kotek-7/DRC-CCTL2026/3dshapes/SO8_SOT96-1_NXP.step

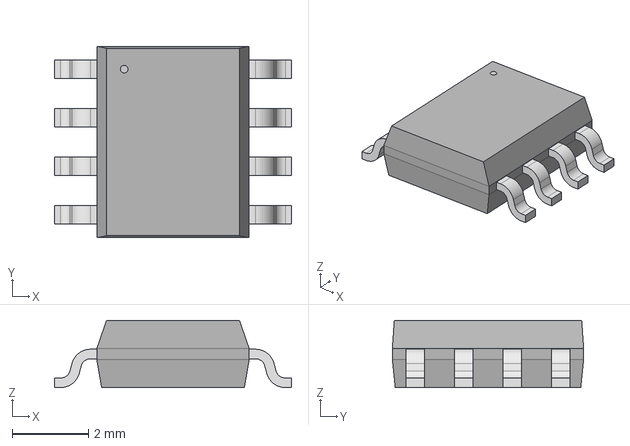
[picture p1: CAD file, 2026-04-17]
3dshapes/SO8_SOT96-1_NXP.step
6.20 x 5.00 x 1.75 mm
