kotek-7/DRC-CCTL2026/3dshapes/AQM1602Y-NLW-FBW.step

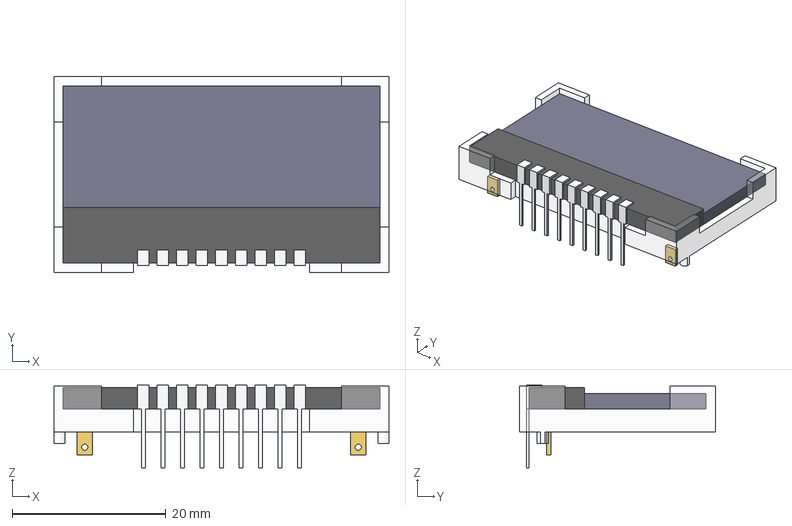
[picture p2: CAD file, 2026-03-31]
3dshapes/AQM1602Y-NLW-FBW.step
43.6 x 25.5 x 10.8 mm
