kotek-7/DRC-CCTL2026/3dshapes/SN74AHCT1G125DBVR.step

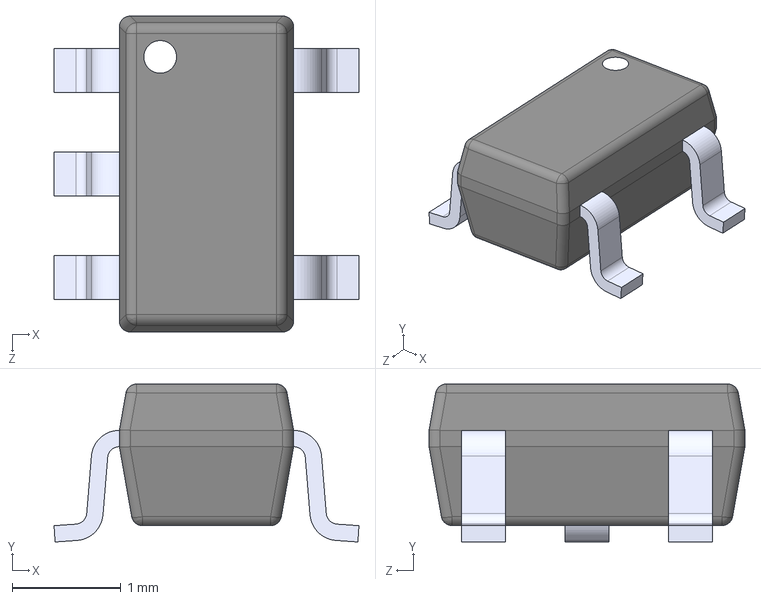
[picture p3: CAD file, 2026-03-31]
3dshapes/SN74AHCT1G125DBVR.step
2.80 x 1.45 x 2.90 mm
