kotek-7/DRC-CCTL2026/3dshapes/AZ1117CH-3.3TRG1.STEP

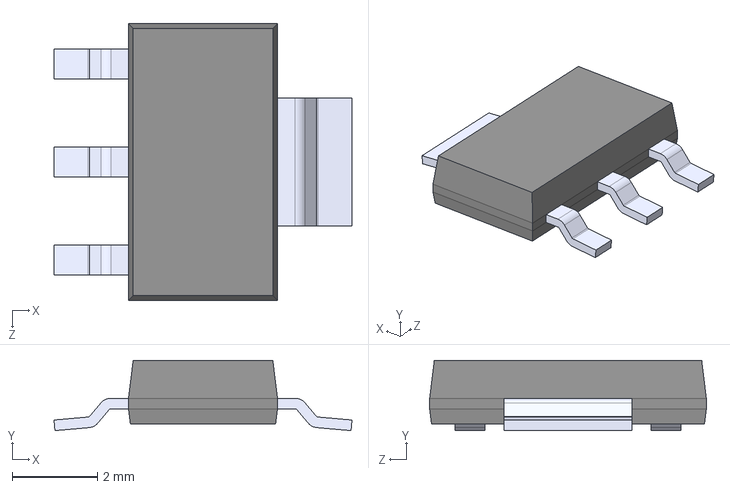
[picture p4: CAD file, 2026-03-31]
3dshapes/AZ1117CH-3.3TRG1.STEP
7.00 x 1.65 x 6.50 mm
