kotek-7/DRC-CCTL2026/DRC-CCTL2026.kicad_pcb

## KiCad design DRC-CCTL2026.kicad_pcb (2026-04-17)

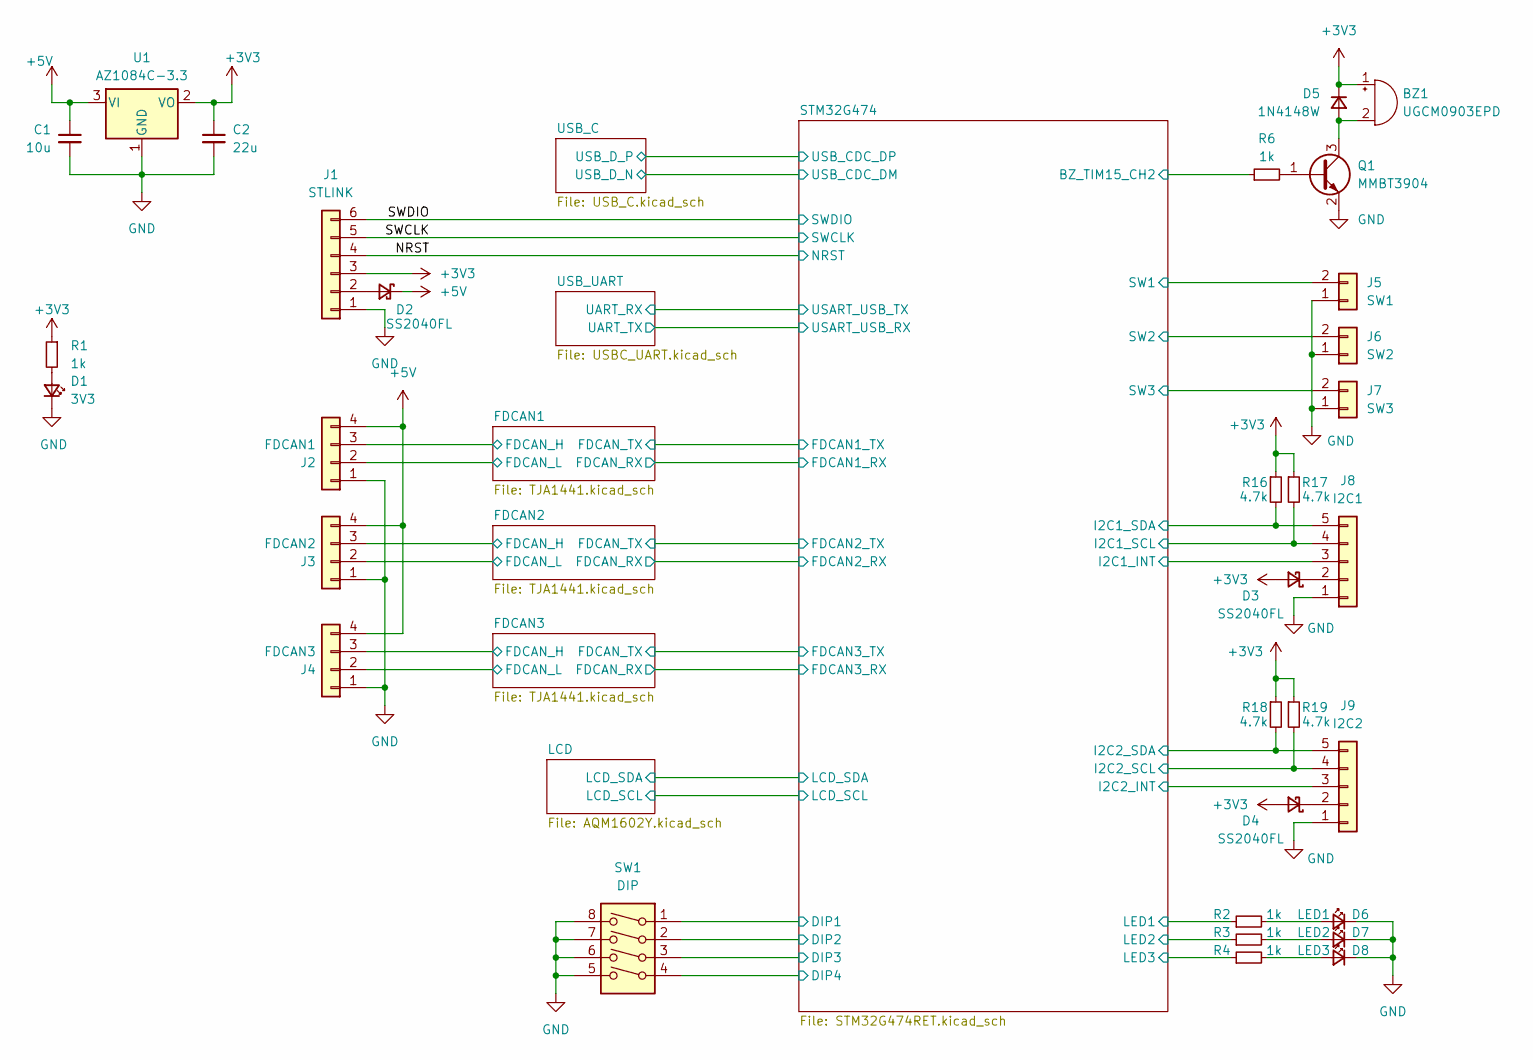
[picture p5: schematic DRC-CCTL2026.kicad_sch]

Parts:
BZ1: UGCM0903EPD; UGCM0903EPD_5_0
C1: 10u; C_0805_2012Metric_Pad1.18x1.45mm_HandSolder
C2: 22u; C_0805_2012Metric_Pad1.18x1.45mm_HandSolder
D1: 3V3; LED_0603_1608Metric_Pad1.05x0.95mm_HandSolder
D2, D3, D4: SS2040FL; D_SOD-123F
D5: 1N4148W; D_SOD-123
D6: LED1; LED_0603_1608Metric_Pad1.05x0.95mm_HandSolder
D7: LED2; LED_0603_1608Metric_Pad1.05x0.95mm_HandSolder
D8: LED3; LED_0603_1608Metric_Pad1.05x0.95mm_HandSolder
J1: STLINK; IDC-Header_2x03_P2.54mm_Vertical
J2: FDCAN1; JST_XH_S4B-XH-A_1x04_P2.50mm_Horizontal; LCSC x
J3: FDCAN2; JST_XH_S4B-XH-A_1x04_P2.50mm_Horizontal; LCSC x
J4: FDCAN3; JST_XH_S4B-XH-A_1x04_P2.50mm_Horizontal; LCSC x
J5: SW1; JST_XH_B2B-XH-A_1x02_P2.50mm_Vertical
J6: SW2; JST_XH_B2B-XH-A_1x02_P2.50mm_Vertical
J7: SW3; JST_XH_B2B-XH-A_1x02_P2.50mm_Vertical
J8: I2C1; JST_XH_S5B-XH-A_1x05_P2.50mm_Horizontal
J9: I2C2; JST_XH_S5B-XH-A_1x05_P2.50mm_Horizontal
Q1: MMBT3904; SOT-23
R1, R2, R3, R4, R6: 1k; R_0603_1608Metric_Pad0.98x0.95mm_HandSolder
R16, R17, R18, R19: 4.7k; R_0603_1608Metric_Pad0.98x0.95mm_HandSolder
SW1: DIP; SW_DIP_SPSTx04_Slide_Copal_CHS-04B_W7.62mm_P1.27mm
U1: AZ1084C-3.3; TO-252-2

Connections:
+3V3: BZ1.1 (+), C2.1, D3.2 (A), D4.2 (A), D5.1 (K), J1.3, R1.1, R16.1, R17.1, R18.1, R19.1, U1.2 (VO); also elsewhere on the board
+5V: C1.1, D2.1 (K), J2.4, J3.4, J4.4, U1.3 (VI); also elsewhere on the board
/FDCAN1/FDCAN_H: J2.3; also elsewhere on the board
/FDCAN1/FDCAN_L: J2.2; also elsewhere on the board
/FDCAN2/FDCAN_H: J3.3; also elsewhere on the board
/FDCAN2/FDCAN_L: J3.2; also elsewhere on the board
/FDCAN3/FDCAN_H: J4.3; also elsewhere on the board
/FDCAN3/FDCAN_L: J4.2; also elsewhere on the board
/NRST: J1.4; also elsewhere on the board
/STM32G474/BZ_TIM15_CH2: R6.1; also elsewhere on the board
/STM32G474/DIP1: SW1.1; also elsewhere on the board
/STM32G474/DIP2: SW1.2; also elsewhere on the board
/STM32G474/DIP3: SW1.3; also elsewhere on the board
/STM32G474/DIP4: SW1.4; also elsewhere on the board
/STM32G474/I2C1_INT: J8.3; also elsewhere on the board
/STM32G474/I2C1_SCL: J8.4, R17.2; also elsewhere on the board
/STM32G474/I2C1_SDA: J8.5, R16.2; also elsewhere on the board
/STM32G474/I2C2_INT: J9.3; also elsewhere on the board
/STM32G474/I2C2_SCL: J9.4, R19.2; also elsewhere on the board
/STM32G474/I2C2_SDA: J9.5, R18.2; also elsewhere on the board
/STM32G474/LED1: R2.1; also elsewhere on the board
/STM32G474/LED2: R3.1; also elsewhere on the board
/STM32G474/LED3: R4.1; also elsewhere on the board
/STM32G474/SW1: J5.2; also elsewhere on the board
/STM32G474/SW2: J6.2; also elsewhere on the board
/STM32G474/SW3: J7.2; also elsewhere on the board
/SWCLK: J1.5; also elsewhere on the board
/SWDIO: J1.6; also elsewhere on the board
GND: C1.2, C2.2, D1.1 (K), D6.1 (K), D7.1 (K), D8.1 (K), J1.1, J2.1, J3.1, J4.1, J5.1, J6.1, J7.1, J8.1, J9.1, Q1.2 (E), SW1.5, SW1.6, SW1.7, SW1.8, U1.1 (GND); also elsewhere on the board
unnamed: BZ1.2 (-), D5.2 (A), Q1.3 (C)
unnamed: D1.2 (A), R1.2
unnamed: D2.2 (A), J1.2
unnamed: D3.1 (K), J8.2
unnamed: D4.1 (K), J9.2
unnamed: D6.2 (A), R2.2
unnamed: D7.2 (A), R3.2
unnamed: D8.2 (A), R4.2
unnamed: Q1.1 (B), R6.2

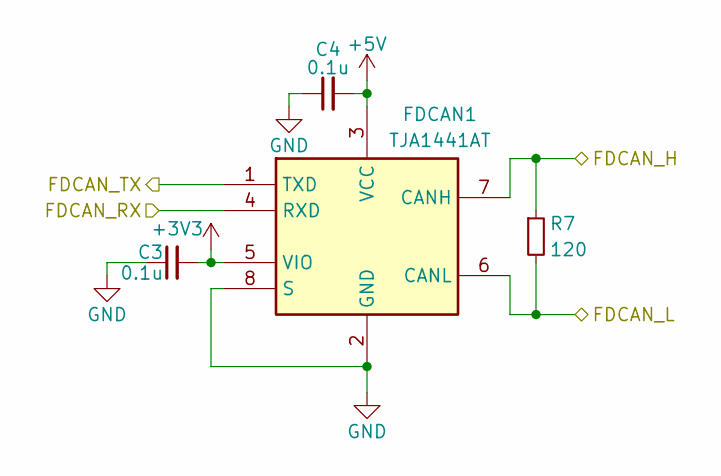
[picture p6: schematic TJA1441.kicad_sch]

Parts:
C3, C4: 0.1u; C_0603_1608Metric_Pad1.08x0.95mm_HandSolder
FDCAN1: TJA1441AT; SO8_SOT96-1_NXP; Manufacturer_Part_Number TJA1441AT
R7: 120; R_0603_1608Metric_Pad0.98x0.95mm_HandSolder

Connections:
+3V3: C3.2, FDCAN1.5 (VIO); also elsewhere on the board
+5V: C4.2, FDCAN1.3 (VCC); also elsewhere on the board
/FDCAN1/FDCAN_H: FDCAN1.7 (CANH), R7.1; also elsewhere on the board
/FDCAN1/FDCAN_L: FDCAN1.6 (CANL), R7.2; also elsewhere on the board
/FDCAN1/FDCAN_RX: FDCAN1.4 (RXD); also elsewhere on the board
/FDCAN1/FDCAN_TX: FDCAN1.1 (TXD); also elsewhere on the board
GND: C3.1, C4.1, FDCAN1.2 (GND), FDCAN1.8 (S); also elsewhere on the board

Parts of its further copies:
C5, C6, C7, C8: 0.1u; C_0603_1608Metric_Pad1.08x0.95mm_HandSolder
FDCAN2, FDCAN3: TJA1441AT; SO8_SOT96-1_NXP; Manufacturer_Part_Number TJA1441AT
R8, R9: 120; R_0603_1608Metric_Pad0.98x0.95mm_HandSolder

Connections of its further copies:
+3V3: C5.2, C7.2, FDCAN2.5 (VIO), FDCAN3.5 (VIO); also elsewhere on the board
+5V: C6.2, C8.2, FDCAN2.3 (VCC), FDCAN3.3 (VCC); also elsewhere on the board
/FDCAN2/FDCAN_H: FDCAN2.7 (CANH), R8.1; also elsewhere on the board
/FDCAN2/FDCAN_L: FDCAN2.6 (CANL), R8.2; also elsewhere on the board
/FDCAN2/FDCAN_RX: FDCAN2.4 (RXD); also elsewhere on the board
/FDCAN2/FDCAN_TX: FDCAN2.1 (TXD); also elsewhere on the board
/FDCAN3/FDCAN_H: FDCAN3.7 (CANH), R9.1; also elsewhere on the board
/FDCAN3/FDCAN_L: FDCAN3.6 (CANL), R9.2; also elsewhere on the board
/FDCAN3/FDCAN_RX: FDCAN3.4 (RXD); also elsewhere on the board
/FDCAN3/FDCAN_TX: FDCAN3.1 (TXD); also elsewhere on the board
GND: C5.1, C6.1, C7.1, C8.1, FDCAN2.2 (GND), FDCAN2.8 (S), FDCAN3.2 (GND), FDCAN3.8 (S); also elsewhere on the board

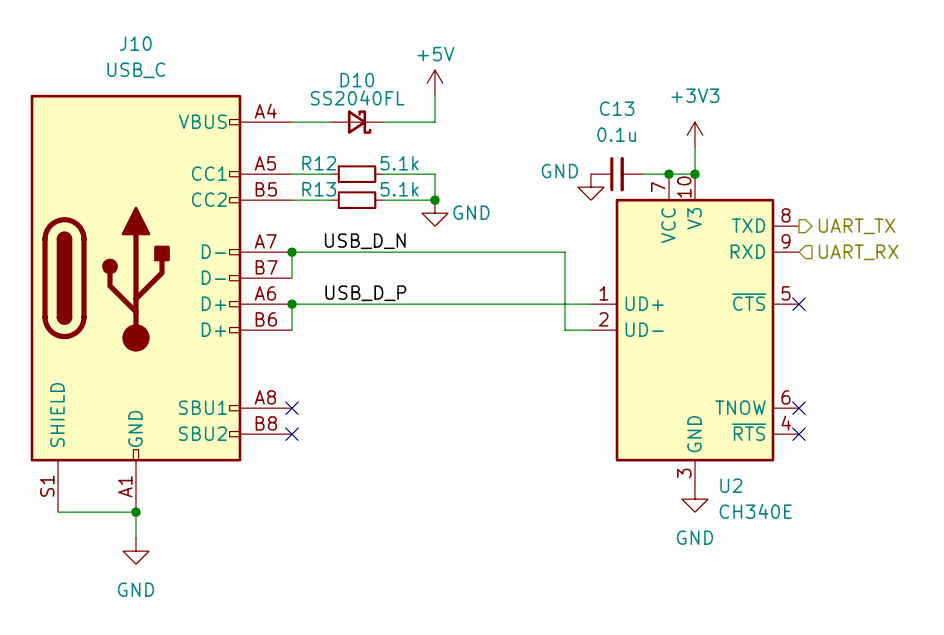
[picture p7: schematic USBC_UART.kicad_sch]

Parts:
C13: 0.1u; C_0603_1608Metric_Pad1.08x0.95mm_HandSolder
D10: SS2040FL; D_SOD-123F
J10: USB_C; USB_C_Receptacle_GCT_USB4105-xx-A_16P_TopMnt_Horizontal
R12, R13: 5.1k; R_0603_1608Metric_Pad0.98x0.95mm_HandSolder
U2: CH340E; MSOP-10_3x3mm_P0.5mm

Connections:
+3V3: C13.2, U2.7 (VCC), U2.10 (V3); also elsewhere on the board
+5V: D10.1 (K); also elsewhere on the board
/STM32G474/USART_USB_RX: U2.8 (TXD); also elsewhere on the board
/STM32G474/USART_USB_TX: U2.9 (RXD); also elsewhere on the board
/USB_UART/USB_D_N: J10.A7 (D-), J10.B7 (D-), U2.2 (UD-)
/USB_UART/USB_D_P: J10.A6 (D+), J10.B6 (D+), U2.1 (UD+)
GND: C13.1, J10.A1 (GND), J10.A12 (GND), J10.B1 (GND), J10.B12 (GND), J10.S1 (SHIELD), R12.2, R13.2, U2.3 (GND); also elsewhere on the board
unnamed: D10.2 (A), J10.A4 (VBUS), J10.A9 (VBUS), J10.B4 (VBUS), J10.B9 (VBUS)
unnamed: J10.A5 (CC1), R12.1
unnamed: J10.B5 (CC2), R13.1

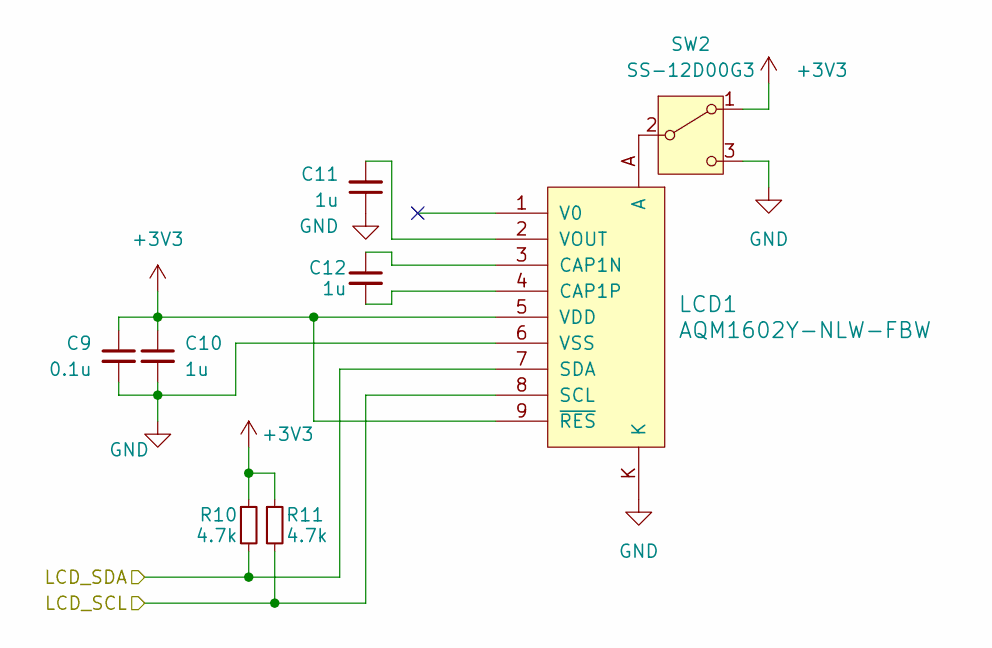
[picture p8: schematic AQM1602Y.kicad_sch]

Parts:
C9: 0.1u; C_0603_1608Metric_Pad1.08x0.95mm_HandSolder
C10, C11, C12: 1u; C_0603_1608Metric_Pad1.08x0.95mm_HandSolder
LCD1: AQM1602Y-NLW-FBW; AQM1602Y-NLW
R10, R11: 4.7k; R_0603_1608Metric_Pad0.98x0.95mm_HandSolder
SW2: SS-12D00G3

Connections:
+3V3: C9.1, C10.1, LCD1.5 (VDD), LCD1.9 (~RES), R10.1, R11.1, SW2.1 (A); also elsewhere on the board
/LCD/LCD_SCL: LCD1.8 (SCL), R11.2; also elsewhere on the board
/LCD/LCD_SDA: LCD1.7 (SDA), R10.2; also elsewhere on the board
GND: C9.2, C10.2, C11.1, LCD1.6 (VSS), LCD1.K, SW2.3 (C); also elsewhere on the board
unnamed: C12.1, LCD1.3 (CAP1N)
unnamed: C12.2, LCD1.4 (CAP1P)
unnamed: C11.2, LCD1.2 (VOUT)
unnamed: LCD1.A, SW2.2 (B)

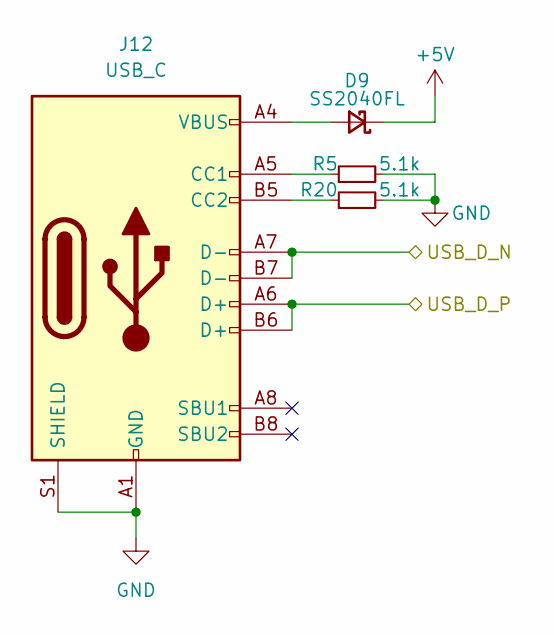
[picture p9: schematic USB_C.kicad_sch]

Parts:
D9: SS2040FL; D_SOD-123F
J12: USB_C; USB_C_Receptacle_GCT_USB4105-xx-A_16P_TopMnt_Horizontal
R5, R20: 5.1k; R_0603_1608Metric_Pad0.98x0.95mm_HandSolder

Connections:
+5V: D9.1 (K); also elsewhere on the board
/STM32G474/USB_CDC_DM: J12.A7 (D-), J12.B7 (D-); also elsewhere on the board
/STM32G474/USB_CDC_DP: J12.A6 (D+), J12.B6 (D+); also elsewhere on the board
GND: J12.A1 (GND), J12.A12 (GND), J12.B1 (GND), J12.B12 (GND), J12.S1 (SHIELD), R5.2, R20.2; also elsewhere on the board
unnamed: D9.2 (A), J12.A4 (VBUS), J12.A9 (VBUS), J12.B4 (VBUS), J12.B9 (VBUS)
unnamed: J12.A5 (CC1), R5.1
unnamed: J12.B5 (CC2), R20.1

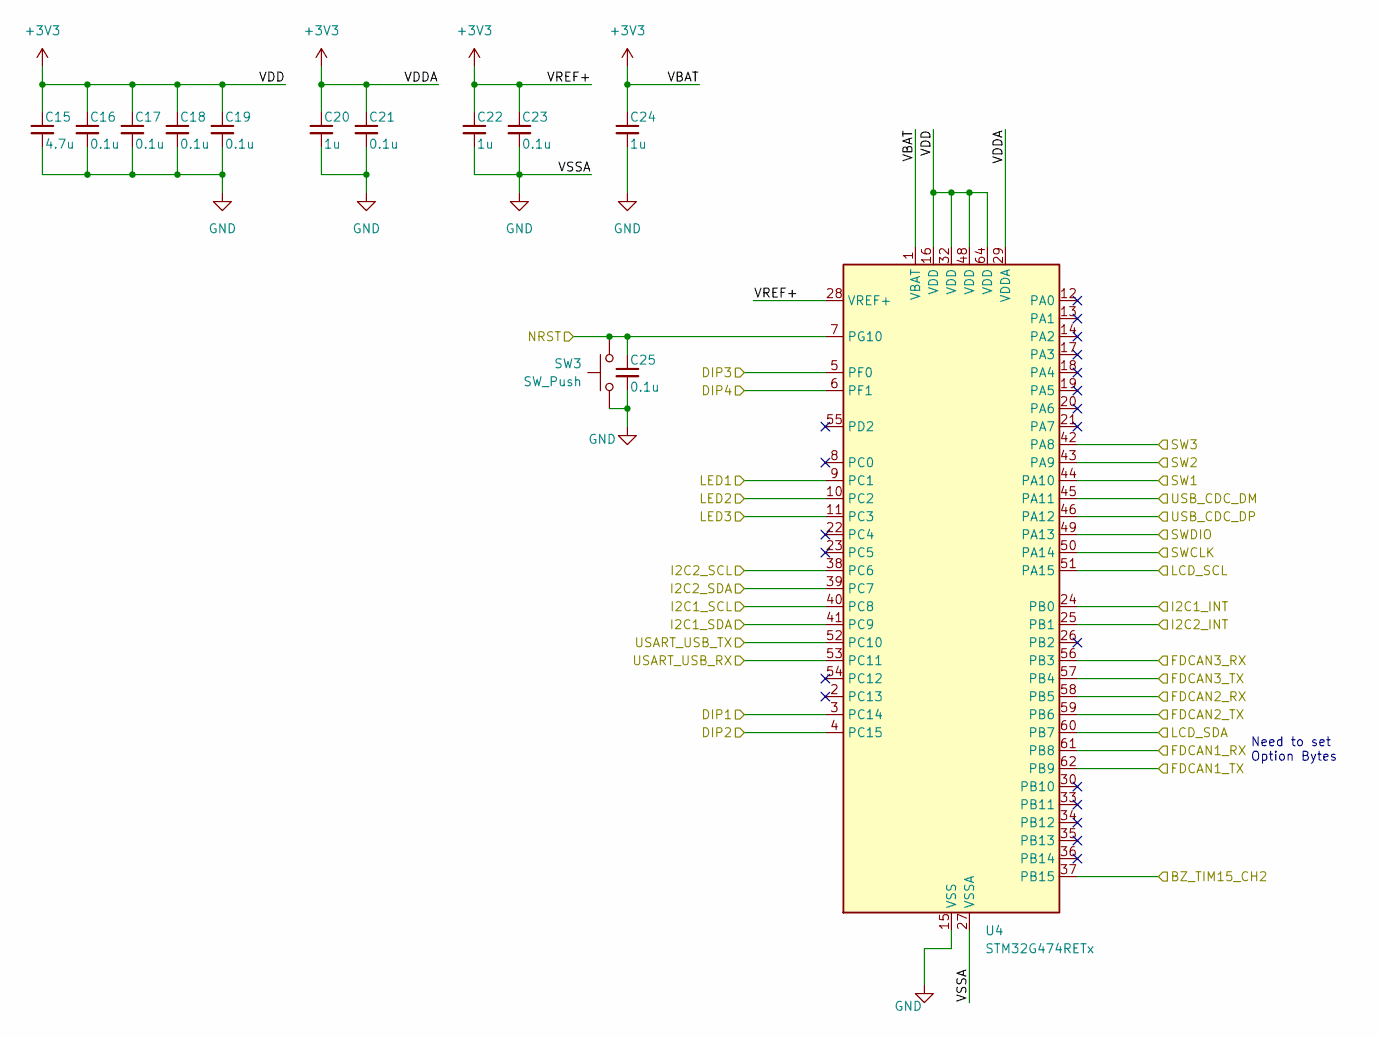
[picture p10: schematic STM32G474RET.kicad_sch]

Parts:
C15: 4.7u; C_0805_2012Metric_Pad1.18x1.45mm_HandSolder
C16, C17, C18, C19, C21, C23, C25: 0.1u; C_0603_1608Metric_Pad1.08x0.95mm_HandSolder
C20, C22, C24: 1u; C_0603_1608Metric_Pad1.08x0.95mm_HandSolder
SW3: SW_Push; SW_SPST_EVQPE1
U4: STM32G474RETx; LQFP-64_10x10mm_P0.5mm

Connections:
+3V3: C15.1, C16.1, C17.1, C18.1, C19.1, C20.1, C21.1, C22.1, C23.1, C24.1, U4.1 (VBAT), U4.16 (VDD), U4.28 (VREF+), U4.29 (VDDA), U4.32 (VDD), U4.48 (VDD), U4.64 (VDD); also elsewhere on the board
/FDCAN1/FDCAN_RX: U4.61 (PB8); also elsewhere on the board
/FDCAN1/FDCAN_TX: U4.62 (PB9); also elsewhere on the board
/FDCAN2/FDCAN_RX: U4.58 (PB5); also elsewhere on the board
/FDCAN2/FDCAN_TX: U4.59 (PB6); also elsewhere on the board
/FDCAN3/FDCAN_RX: U4.56 (PB3); also elsewhere on the board
/FDCAN3/FDCAN_TX: U4.57 (PB4); also elsewhere on the board
/LCD/LCD_SCL: U4.51 (PA15); also elsewhere on the board
/LCD/LCD_SDA: U4.60 (PB7); also elsewhere on the board
/NRST: C25.1, SW3.1, U4.7 (PG10); also elsewhere on the board
/STM32G474/BZ_TIM15_CH2: U4.37 (PB15); also elsewhere on the board
/STM32G474/DIP1: U4.3 (PC14); also elsewhere on the board
/STM32G474/DIP2: U4.4 (PC15); also elsewhere on the board
/STM32G474/DIP3: U4.5 (PF0); also elsewhere on the board
/STM32G474/DIP4: U4.6 (PF1); also elsewhere on the board
/STM32G474/I2C1_INT: U4.24 (PB0); also elsewhere on the board
/STM32G474/I2C1_SCL: U4.40 (PC8); also elsewhere on the board
/STM32G474/I2C1_SDA: U4.41 (PC9); also elsewhere on the board
/STM32G474/I2C2_INT: U4.25 (PB1); also elsewhere on the board
/STM32G474/I2C2_SCL: U4.38 (PC6); also elsewhere on the board
/STM32G474/I2C2_SDA: U4.39 (PC7); also elsewhere on the board
/STM32G474/LED1: U4.9 (PC1); also elsewhere on the board
/STM32G474/LED2: U4.10 (PC2); also elsewhere on the board
/STM32G474/LED3: U4.11 (PC3); also elsewhere on the board
/STM32G474/SW1: U4.44 (PA10); also elsewhere on the board
/STM32G474/SW2: U4.43 (PA9); also elsewhere on the board
/STM32G474/SW3: U4.42 (PA8); also elsewhere on the board
/STM32G474/USART_USB_RX: U4.53 (PC11); also elsewhere on the board
/STM32G474/USART_USB_TX: U4.52 (PC10); also elsewhere on the board
/STM32G474/USB_CDC_DM: U4.45 (PA11); also elsewhere on the board
/STM32G474/USB_CDC_DP: U4.46 (PA12); also elsewhere on the board
/SWCLK: U4.50 (PA14); also elsewhere on the board
/SWDIO: U4.49 (PA13); also elsewhere on the board
GND: C15.2, C16.2, C17.2, C18.2, C19.2, C20.2, C21.2, C22.2, C23.2, C24.2, C25.2, SW3.2, U4.15 (VSS), U4.27 (VSSA), U4.31 (VSS), U4.47 (VSS), U4.63 (VSS); also elsewhere on the board

Notes on the sheet:
Need to set Option Bytes

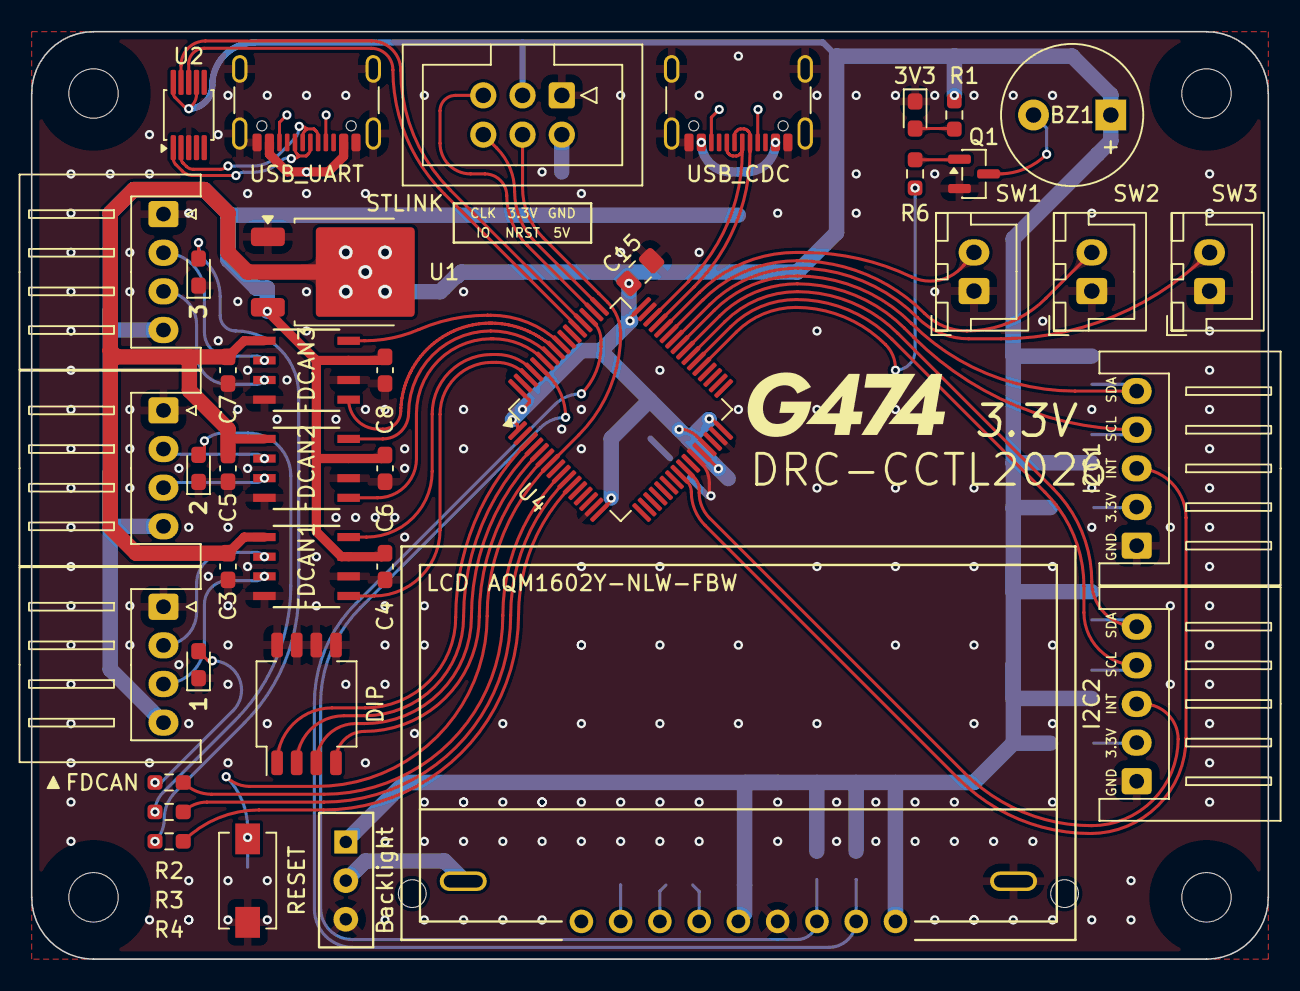
[picture p11: board DRC-CCTL2026.kicad_pcb from above]

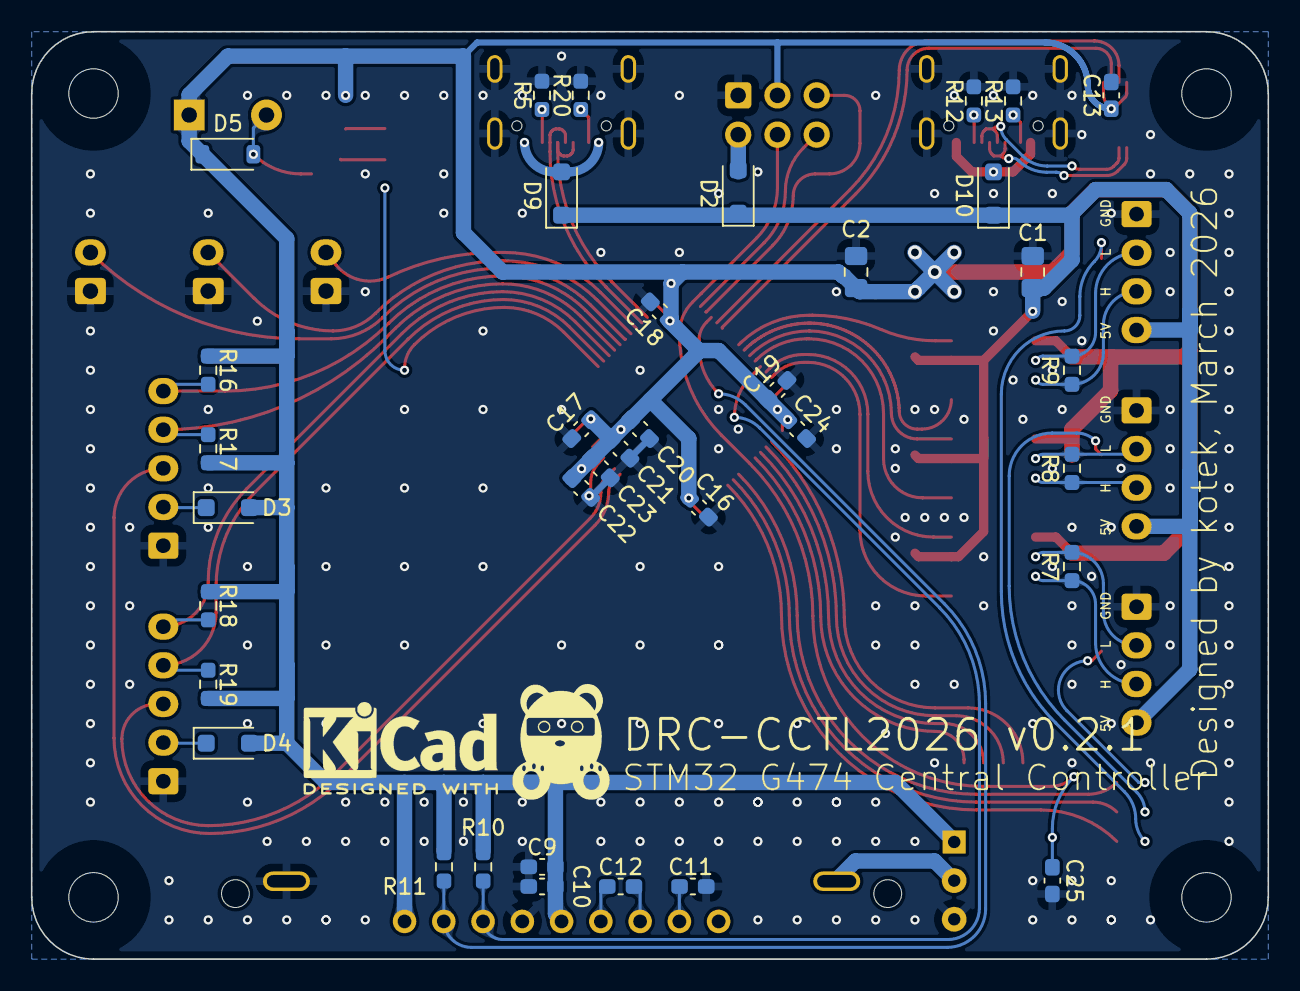
[picture p12: board DRC-CCTL2026.kicad_pcb from below]

Board: 2 copper layers, 80.0 x 60.0 mm, 75 parts (36 on the bottom side), 62 nets.
