kotek-7/DRC-CCTL2026/example/DRC-CCTL2026.ioc

Mcu.UserName=STM32G474RETx
PA10.GPIO_Label=SW1
PA10.Signal=GPIO_Input
PA11.GPIO_Label=USB_CDC_DM
PA11.Signal=USB_DM
PA12.GPIO_Label=USB_CDC_DP
PA12.Signal=USB_DP
PA13.Signal=SYS_JTMS-SWDIO
PA14.Signal=SYS_JTCK-SWCLK
PA15.GPIO_Label=LCD_SCL
PA15.Signal=I2C1_SCL
PA8.GPIO_Label=SW3
PA8.Signal=GPIO_Input
PA9.GPIO_Label=SW2
PA9.Signal=GPIO_Input
PB0.GPIO_Label=I2C1_INT
PB0.Signal=GPIO_Input
PB1.GPIO_Label=I2C2_INT
PB1.Signal=GPIO_Input
PB15.GPIO_Label=BZ_TIM15_CH2
PB15.Signal=S_TIM15_CH2
PB3.Signal=FDCAN3_RX
PB4.Signal=FDCAN3_TX
PB5.Signal=FDCAN2_RX
PB6.Signal=FDCAN2_TX
PB7.GPIO_Label=LCD_SDA
PB7.Signal=I2C1_SDA
PB8-BOOT0.Signal=FDCAN1_RX
PB9.Signal=FDCAN1_TX
PC1.GPIO_Label=LED1
PC1.Signal=GPIO_Output
PC10.GPIO_Label=USART_USB_TX
PC10.Signal=USART3_TX
PC11.GPIO_Label=USART_USB_RX
PC11.Signal=USART3_RX
PC14-OSC32_IN.GPIO_Label=DIP1
PC14-OSC32_IN.Signal=GPIO_Input
PC15-OSC32_OUT.GPIO_Label=DIP2
PC15-OSC32_OUT.Signal=GPIO_Input
PC2.GPIO_Label=LED2
PC2.Signal=GPIO_Output
PC3.GPIO_Label=LED3
PC3.Signal=GPIO_Output
PC6.GPIO_Label=I2C2_SCL
PC6.Signal=I2C4_SCL
PC7.GPIO_Label=ISC2_SDA
PC7.Signal=I2C4_SDA
PC8.GPIO_Label=I2C1_SCL
PC8.Signal=I2C3_SCL
PC9.GPIO_Label=I2C1_SDA
PC9.Signal=I2C3_SDA
PF0-OSC_IN.GPIO_Label=DIP3
PF0-OSC_IN.Signal=GPIO_Input
PF1-OSC_OUT.GPIO_Label=DIP4
PF1-OSC_OUT.Signal=GPIO_Input
PG10-NRST.GPIO_Label=NRST
PG10-NRST.Signal=GPIO_Input
