kotek-7/DRC-CCTL2026/(commit log)

2026-03-31 シルクスクリーン被りを修正
    [DRC-CCTL2026.kicad_pcb]
2026-03-31 LCDの3dモデルを追加、スルーホールを調整
    [AQM1602Y-NLW-FBW.step, DRC-CCTL2026.kicad_pcb]
2026-03-31 DRCを実行
    [DRC-CCTL2026.kicad_pcb]
2026-03-31 画像を差し替え
2026-03-31 T字配線にフィレットを追加
    [DRC-CCTL2026.kicad_pcb]
2026-03-31 不要なビアを削除
    [DRC-CCTL2026.kicad_pcb]
2026-03-31 配線を改善
    [DRC-CCTL2026.kicad_pcb]
2026-03-31 ledの抵抗値を変更
    [DRC-CCTL2026.kicad_pcb, DRC-CCTL2026.kicad_sch]
2026-04-01 バージョンを変更
    [DRC-CCTL2026.kicad_pcb]
2026-04-02 パターン引き直し・部品配置変更
    [DRC-CCTL2026.kicad_pcb, DRC-CCTL2026.kicad_sch]
2026-04-02 drc実行
    [DRC-CCTL2026.kicad_pcb]
2026-04-03 v10対応
    [DRC-CCTL2026.kicad_pcb]
2026-04-04 gitignore を変更
2026-04-04 Revert "v10対応"
    This reverts commit baf912c2f8df2bec777aa3791820c88b0f144cdf.
    [DRC-CCTL2026.kicad_pcb]
2026-04-04 CANの終端抵抗を削除、シルクスクリーンを調整
    [AQM1602Y.kicad_sch, DRC-CCTL2026.kicad_pcb, DRC-CCTL2026.kicad_sch, TJA1441.kicad_sch]
2026-04-05 JLCPCB用に書き出し、v0.1.0
2026-04-12 サンプルコードを追加
2026-04-14 platformio.iniのenvを統合
2026-04-14 ファイルを移動
2026-04-14 STM32 VSCode Extention に対応
2026-04-14 halで各サンプルを記述
2026-04-15 pio の不要な例は削除
2026-04-17 v0.2.1, USB CDC に対応
    [DRC-CCTL2026.kicad_pcb, DRC-CCTL2026.kicad_sch, STM32G474.kicad_sch, STM32G474RET.kicad_sch, USBC_UART.kicad_sch, USB_C.kicad_sch]
2026-04-17 JLCPCB用に書き出し
2026-04-17 JLCPCB用に書き出し2
    [DRC-CCTL2026.kicad_pcb]
2026-04-17 バージョン表記を修正・JLCPCBに書き出し
    [DRC-CCTL2026.kicad_pcb]
2026-05-02 bom を生成
2026-05-12 サンプルをv0.2.1に向けて追加
